fulda1/FERDA_v2/hardware/README.md

# FERDA_v2 - Hardware
This folder contains schematic and PCB gerber file.
