fulda1/FERDA_v2/hardware/FERDA_v2_.jpg

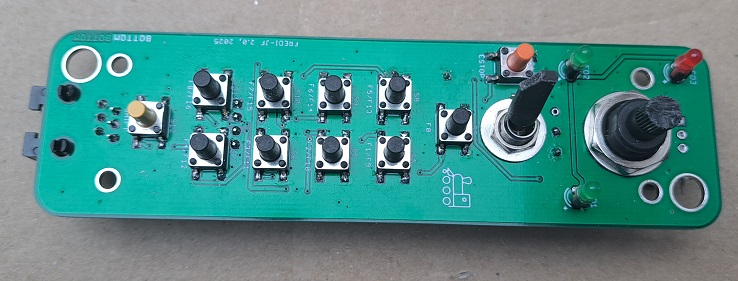
hardware/FERDA_v2_.jpg
