fulda1/FERDA_v2/hardware/FERDA_v2__.jpg

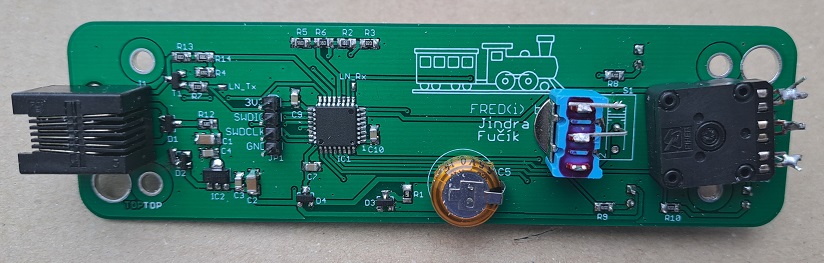
hardware/FERDA_v2__.jpg
