fulda1/FERDA_v2/hardware/FERDA_v2_sch.pdf

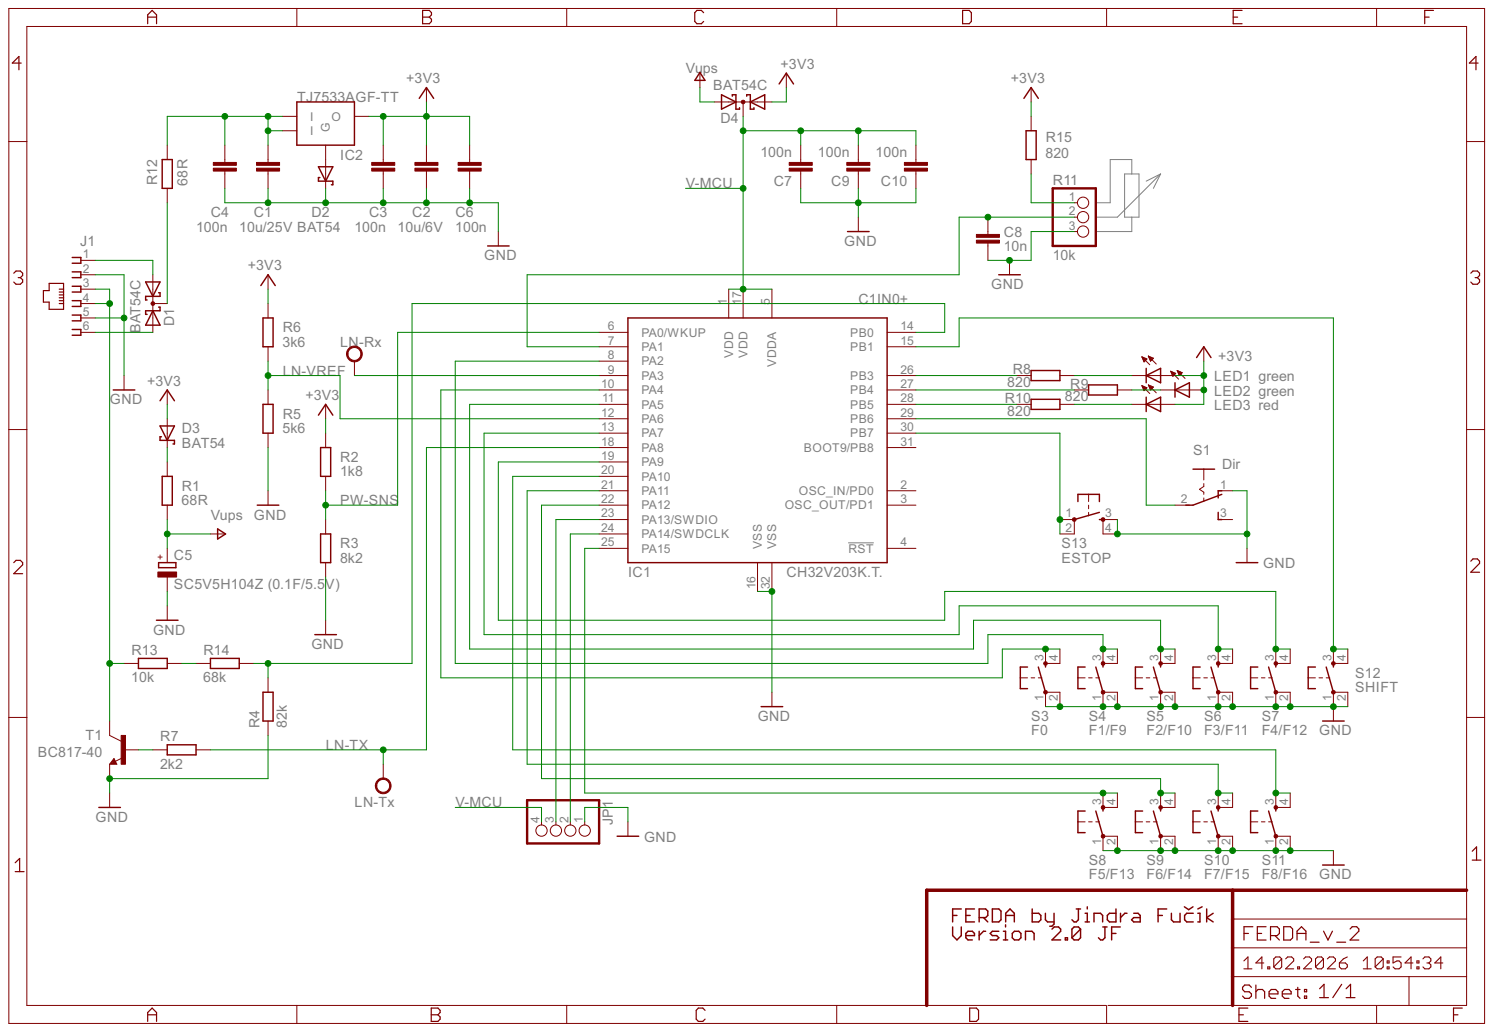
[picture p5: page 1]
