fulda1/FERDA_v2/(notices)

Notices in the files:
README.md:
CC https://raw.githubusercontent.com/fulda1/FERDA_v2/refs/heads/main/hardware/cc-icons.svg#cc-by NC
